lcook42/MAPQuest_PPG/research/PPG_Occlusion_Research_Kit/templates/session_notes.md

# One acquisition session

- Session ID / date / operator:
- BENCH or protocol identifier (no patient names in research files):
- Firmware version / pressure profile / device and sensor serial numbers:
- Pressure reference instrument / calibration certificate / uncertainty / date:
- ZERO performed with port vented: yes/no; time:
- Gain and calibration-result file:
- RED / IR / GREEN LED codes:
- Optical fixture, position and contact force method:
- Cuff size / location / tubing and tee arrangement:
- Ambient and instrument temperature / stabilization time:
- Supply method (battery, USB, isolation arrangements):
- Pressure sequence and ramp rates actually recorded:
- Leak check / return-to-zero results:
- Marker definitions / operator / independent flow method:
- Motion, saturation, FIFO backlog, conversion faults, resets or other exclusions:
- Recorded files:
- Repeat number / remounting / between-session changes:
- Clinical reference method and synchronized measurement interval, if authorized:
- Notes:

Pressure at a marker is pneumatic pressure, not automatically MAP. This form does not authorize human testing.
