lcook42/MAPQuest_PPG/research/PPG_Occlusion_Research_Kit/examples/SIMULATED_review.png

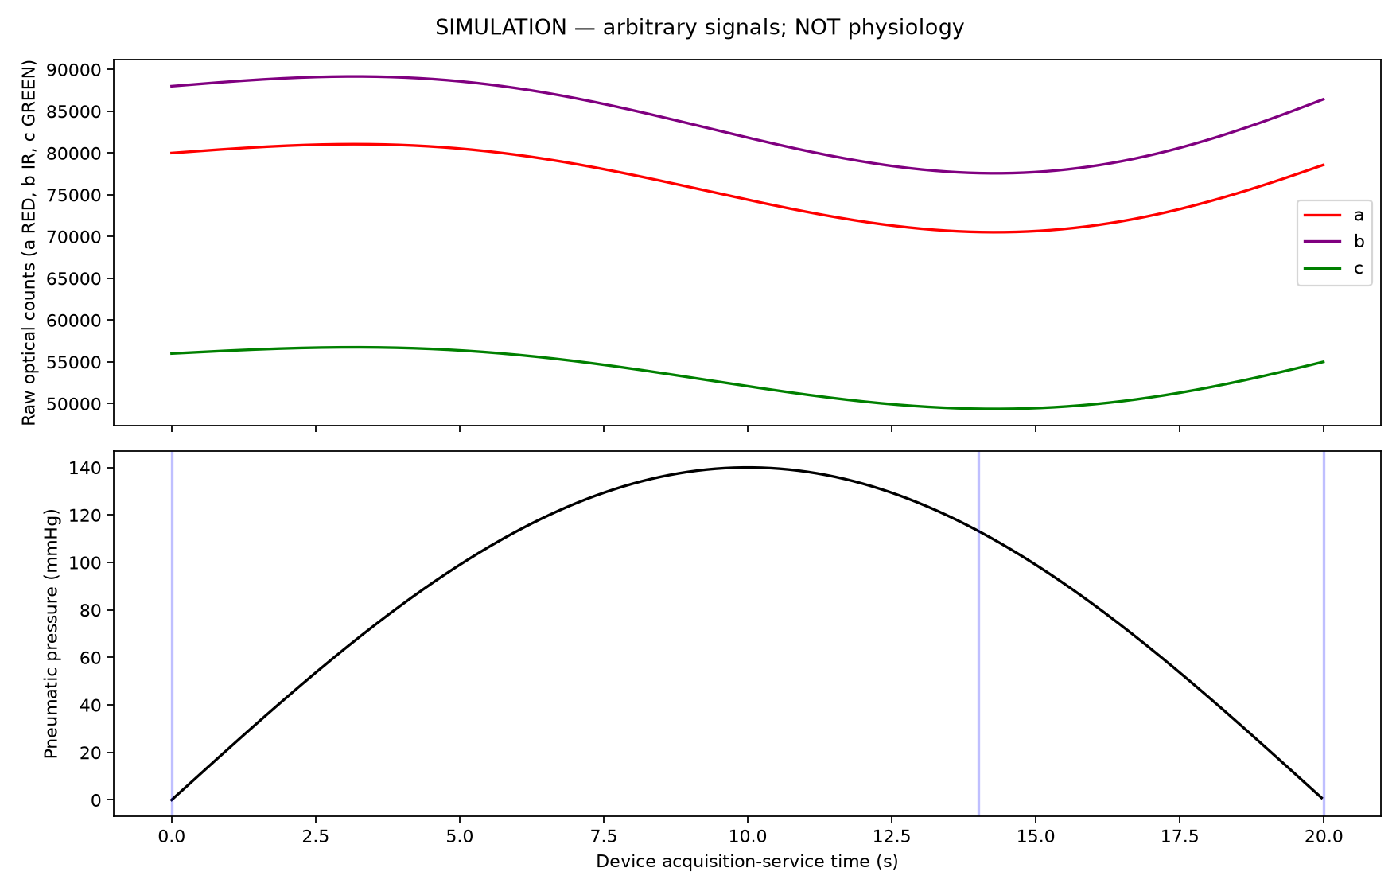
research/PPG_Occlusion_Research_Kit/examples/SIMULATED_review.png
