lcook42/MAPQuest_PPG/esp32/MAX30101_ManualCuff_RTF/PlatformIO/tools/dashboard.html

# PPG Return to Flow

Manual cuff · arm-mounted PPG · no external MAP calibration

SYNTHETIC DEMO — NO SENSOR OR PERSON IS BEING MEASURED. DO NOT INFLATE A CUFF.

CONNECTINGWaiting for recorder

Keep the cuff fully deflated during setup.

1. Calibrate2. Start cuff phase3. Start return phaseSTOP — release cuff

Cuff is fully released Press only after physically releasing the cuff. Software cannot release it.

Reset sessionSkip recovery waitConnect wirelessly…

Reset clears calibration and live data, reconnects the recorder, and starts a new recording. Previous files are kept. Skip recovery wait allows immediate recalibration after full cuff release.

Pulse remaining / baseline—

Pulse agreement—

Cuff phase elapsed—

Last gauge annotation—

Gauge pressure Record pressureAnnotations are not continuous pressure measurements.

“Suppressed” means sustained loss of detectable pulses with acceptable optical contact. It is consistent with occlusion, not independent proof of zero flow.

Calibration and channel quality

Calibrate to select the RTF channel pair.

Pulse fit measures each channel against a repeating pulse model. Pair agreement measures similarity between channels. Neither percentage is measurement accuracy. Slow (<0.5 Hz) and high-frequency (>8 Hz) content describe detrended signal energy; they are not a validated noise or accuracy score.

Calibration history for this session

Use retained attempts to guide the next calibration

Previous results suggest LED settings. Every search still tests all three pairs with new samples and requires a fresh baseline. Remove an attempt after changing placement or if its data should not guide the next search. Removal excludes its influence but preserves the recording.

Clear calibration history

Raw optical waveforms

RED (coral), IR (cyan), GREEN (green). DC-centered, shared automatic scale in ADC counts. The plot resets after LED changes and omits settling samples; all raw samples are saved.

Detrended view

The same samples with a straight-line drift removed from each channel. Display only: no smoothing or change to detection. Each chart has its own scale.

Analysis uses separate four-second windows. Return requires two windows, so confirmation is delayed; no exact onset time or MAP is claimed.

Why this check may have failed

Suggestions describe possible causes, not a confirmed diagnosis.

Result

No confirmed return yet.

Live guidance
