lcook42/MAPQuest_PPG/esp32/MAX30101_ManualCuff_RTF/PlatformIO/tools/diagnostic.html

# Arm PPG diagnostics

Keep the cuff fully deflated. No baseline required. No occlusion, RTF, MAP or pulse-validity decision is made here.

Connecting…

Stop recording

## Three optical channels

Each trace is centered and scaled independently to reveal its shape. Similar height does not mean equal amplitude or a valid pulse.

## Signal measurements

Channel | DC level | Detrended RMS | Range check

RMS includes noise and movement; it is not pulse amplitude or confidence.

## Manual drive-current comparison

Register codes 1–200; not milliamps. Changing a setting resets the analysis window and is recorded with the samples.

Red IR Green Apply currents
