lcook42/MAPQuest_PPG/(commit log)

2026-10-06 wip: fingertip-waveform build before SPEC.md arrived
2026-10-06 Add hardware bench check, fix sensor-presence reporting
2026-10-06 Detect link failures; fix false-positive pulse detection
    The pulse detector took the largest in-band FFT bin and compared it to a
    distant HF floor. On a drift-dominated recording the spectrum falls
    monotonically, so that lands on the band's lower edge and reports a
    confident SNR for a pulse that is not there. Now requires a local peak
    with prominence, which 1/f drift does not have.
    Also: typed LinkLost/LinkStalled errors with port diagnostics, partial
    capture salvage, and board-reset detection. Previously a silent port
    spun forever on empty reads and a disconnect raised a bare pyserial
    traceback, losing the capture.
2026-10-06 Add arm-raise provocation test for blood-volume response
    SPEC 3.5 can pass with no blood in the light path, and the cardiac pulse
    is a poor gate: the measurement detects slow venous filling, which is
    roughly 10x larger. Raising the arm drains venous blood and lowering it
    pools blood, driving the same slow-DC pathway without a cuff.
    Rests before and after each manoeuvre (ABA) so baseline drift cancels
    instead of reading as a response - verified against 1500 counts of
    linear drift, which correctly classifies as flat.
    Also rate-limits the progress line, which was printing per sample.
2026-10-06 Record full firmware config in provocation CSVs; add --reanalyse
    The capture header omitted LED amplitudes, so a run could not be
    reproduced or compared against another - and LED current is the first
    thing worth varying, since red drifts ~90x more than IR on real data.
    Adds provocation.load_csv and a --reanalyse entry point so a saved run
    can be re-checked without hardware.
2026-10-06 Add decision log; record wrist deviation and recover lost rationale
    Documentation audit found two gaps. The wrist measurement site deviates
    from SPEC 2.1/8 (ventral forearm) and was recorded nowhere as a decision.
    And deleting docs/design.md during the SPEC restructure lost the rationale
    for the inline MAX30101 driver - specifically the SparkFun library's
    slot-named FIFO getters, where getFIFORed() returns whatever is in slot 1.
    Recovered from 782fbd5.
    docs/decisions.md is append-only: superseded entries stay visible rather
    than being edited, so the reasoning that led somewhere wrong is still
    readable. Covers 19 decisions and 3 open questions.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
2026-10-06 Add explicit LED current flags and die-temperature bracketing
    O1 (red drift) needs a controlled experiment, which auto-tune cannot
    provide. --ir-amp/--red-amp pin a channel and exclude it from tuning.
    Each capture is now bracketed by a TEMP reading, so the LED self-heating
    hypothesis is measured rather than inferred - the datasheet gives up to
    8 C rise at high current, enough to move red output and wavelength.
    Also fixes the plain-capture CSV writer, which still emitted only three
    header lines; the same gap was already fixed for provocation captures.
2026-10-06 Persist console reports and the auto-tune trajectory
    Results that only existed on screen could not be reviewed after a run.
    --save now also writes a .log.txt of the full report, and the auto-tune
    amp->DC pairs go into the CSV header.
    That trajectory is a DC-versus-LED-current curve - data bearing directly
    on the red-drift question - and it was being printed and discarded.
2026-10-09 Add independent XIAO reference and no-reference prototypes with research acquisition kit
2026-10-13 Add current ESP32 three-channel RTF firmware and monitor
